codingABI/solarTemperatureLogger/solarTemperatureLogger/displayLanguage.h

// Display strings
#pragma once

// ---------------------------------------------------------------
#ifdef DISPLAYLANGUAGE_DE

#define STR_DCF77SYNC "Zeit-Sync"
#define STR_DCF77MISSING "Zeit ausstehend"
#define STR_DONE "Ok"
#define STR_BACK "Zur\201ck"
#define STR_SAVED "Gespeichert"
#define STR_RESETBUFFER "Puffer l\224schen"
#define STR_SENDBUFFER "Puffer senden"
#define STR_VIEWBUFFER "Puffer zeigen"
#define STR_TIMEDATE "Zeit/Datum"
#define STR_BUFFEREMPTY "Leerer Puffer"
#define STR_POWERSOURCE "Stromquelle"
#define STR_SOLARPOWER "Solar"
#define STR_BATTERYPOWER "Batterie"
#define STR_USBPOWERBANK "USB-Powerbank"
#define STR_RECORDMODE "Aufzeichnung"
#define STR_NORECORDING "Manuell"
#define STR_AT0x00 "Jede Stunde"
#endif

// ---------------------------------------------------------------
#ifdef DISPLAYLANGUAGE_EN

#define STR_DCF77SYNC "Time sync"
#define STR_DCF77MISSING "Time missing"
#define STR_DONE "Done"
#define STR_BACK "Back"
#define STR_SAVED "Saved"
#define STR_RESETBUFFER "Reset buffer"
#define STR_SENDBUFFER "Send buffer"
#define STR_VIEWBUFFER "View buffer"
#define STR_TIMEDATE "Time/Date"
#define STR_BUFFEREMPTY "Empty buffer"
#define STR_POWERSOURCE "Power source"
#define STR_SOLARPOWER "Solar"
#define STR_BATTERYPOWER "Battery"
#define STR_USBPOWERBANK "USB powerbank"
#define STR_RECORDMODE "Record mode"
#define STR_NORECORDING "Manual"
#define STR_AT0x00 "Every hour"
#endif
